JCMelendezT/IAoT/detector/resultados/deteccion_distancia_dron.xlsx

Detector de drones — detección contra distancia
Firmware nodo_detector en el ESP32-S3 · DJI Neo 2 con su control en 2,4 GHz · alerta = 2 ventanas seguidas de «dron»
Distancia (m) | En tierra | En vuelo | Tiempo hasta la alerta (s) | Notas
1 | sí | sí |  | Probado el 10-nov en el estudio
5 | sí |  |  | Dentro de casa, dron con motores apagados
8 |  | sí |  | Dentro de casa, dron volando
Resumen
Distancias probadas | 3
Detectado en tierra | 100%
Detectado en vuelo | 100%
Mayor distancia con alerta en tierra (m) | 5.0
Mayor distancia con alerta en vuelo (m) | 8.0
Tiempo promedio hasta la alerta (s)
Cómo llenarla
• Celdas amarillas: las llenas tú. «En tierra» y «En vuelo» tienen lista desplegable sí / no.
• Texto azul: datos escritos a mano, según lo que reportaste el 10-nov.
• El resumen se calcula solo con fórmulas; las celdas vacías no cuentan.
• «Tiempo hasta la alerta»: segundos desde que enciendes el control hasta que sale >>> ALERTA (lo esperado es unos 4 s).
