JCMelendezT/IAoT/detector/resultados/matriz_confusion.png

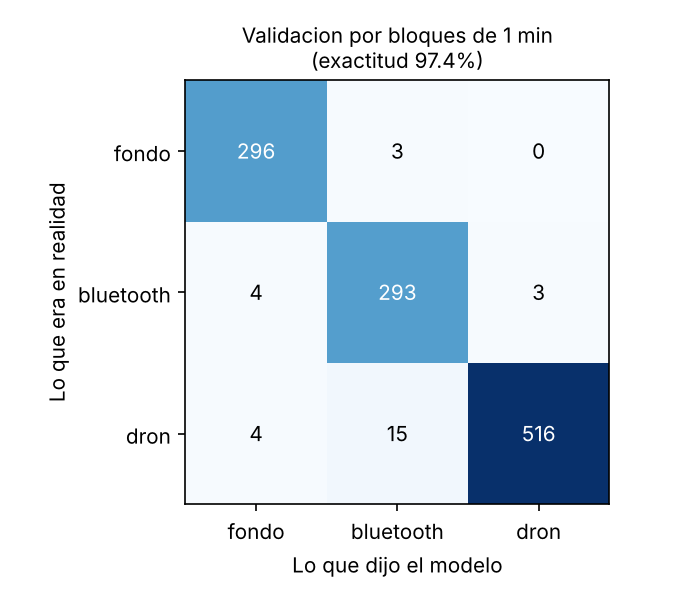
detector/resultados/matriz_confusion.png
