JCMelendezT/IAoT/firmware/devkit_centinela/app_web.h

// App del celular comprimida con gzip. Generado por app/empaquetar.py.
// No editar a mano: cambia index.html o entrenamiento.js y vuelve a correr el script.
#pragma once
#include <pgmspace.h>

const size_t APP_HTML_GZ_LEN = 14802;
const uint8_t APP_HTML_GZ[] PROGMEM = {
  0x1f, 0x8b, 0x08, 0x00, 0x00, 0x00, 0x00, 0x00, 0x02, 0xff, 0xbd, 0x7d, 0x4b, 0x93, 0x1b, 0xb9, 0xb5, 0xe6, 0x5e, 0xbf,
  0x22, 0x3b, 0xdd, 0x8f, 0x64, 0x8b, 0xcc, 0x2a, 0xd6, 0xab, 0xd5, 0xf5, 0xd2, 0xe8, 0xd9, 0x2d, 0x5b, 0xaf, 0xab, 0x92,
  0xbb, 0x6d, 0x97, 0xeb, 0x2a, 0x92, 0x64, 0x92, 0x95, 0x12, 0xc9, 0x64, 0x67, 0x92, 0xac, 0x2a, 0xc9, 0x8a, 0xf0, 0x6a,
  0x7e, 0xc0, 0xcc, 0xac, 0x26, 0x66, 0x16, 0xde, 0x4c, 0xc4, 0xc4, 0x44, 0x2f, 0x6e, 0xdc, 0xc5, 0x44, 0x78, 0x16, 0x13,
  0x61, 0xfd, 0x13, 0xff, 0x92, 0xf9, 0xce, 0x39, 0x00, 0x12, 0x48, 0x66, 0x92, 0x2c, 0xb5, 0x7a, 0x7c, 0xaf, 0xad, 0x22,
  0x12, 0x38, 0x00, 0x0e, 0xce, 0x1b, 0x07, 0xc0, 0xe1, 0x67, 0xbd, 0xb4, 0x3b, 0xbd, 0x9a, 0xc4, 0xde, 0xf9, 0x74, 0x34,
  0x3c, 0xbe, 0x71, 0x48, 0xff, 0x78, 0xc3, 0x68, 0x3c, 0x38, 0xf2, 0xe3, 0xdc, 0xa7, 0x82, 0x38, 0xea, 0xe1, 0x9f, 0x51,
  0x3c, 0x8d, 0xbc, 0xee, 0x79, 0x94, 0xe5, 0xf1, 0xf4, 0xc8, 0x9f, 0x4d, 0xfb, 0xad, 0x5b, 0xbe, 0x2e, 0x1e, 0x47, 0xa3,
  0xf8, 0xc8, 0x9f, 0x27, 0xf1, 0xc5, 0x24, 0xcd, 0xa6, 0xbe, 0xd7, 0x4d, 0xc7, 0xd3, 0x78, 0x8c, 0x6a, 0x17, 0x49, 0x6f,
  0x7a, 0x7e, 0xd4, 0x8b, 0xe7, 0x49, 0x37, 0x6e, 0xf1, 0x8f, 0xa6, 0x97, 0x8c, 0x93, 0x69, 0x12, 0x0d, 0x5b, 0x79, 0x37,
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
  0xf7, 0xbd, 0xdd, 0x65, 0xf3, 0x32, 0x98, 0x21, 0xe8, 0x98, 0x0b, 0xfa, 0xc7, 0x0a, 0x26, 0x3d, 0x55, 0x8d, 0x49, 0xaf,
  0x21, 0xe8, 0x56, 0xff, 0x31, 0x93, 0x69, 0xd3, 0x60, 0x47, 0xd1, 0x65, 0xd0, 0xde, 0x9b, 0x5c, 0x36, 0x2b, 0x07, 0x3d,
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
};
