JCMelendezT/IAoT/(commit log)

2026-10-19 Estructura inicial del repositorio IAoT
    Agrega AGENTS.md para OpenCode, índice de estado, bitácora de decisiones,
    plan de la Práctica 1 orientada al detector de drones por radiofrecuencia
    y el esqueleto de carpetas para firmware, captura de datos y ML.
    Los PDFs de clase quedan fuera del control de versiones.
    [sesiones.csv]
2026-10-19 Orientar la Práctica 1 al nodo detector, sin DHT
    El profesor autorizó cambiar el caso de uso. Los datos del servidor pasan a
    ser ventanas de rasgos WiFi, resumen del espectro nRF24, eventos de detección
    y latidos. Se renombra esp32-dht a esp32-cliente y se actualizan AGENTS.md,
    el índice y la bitácora de decisiones.
2026-10-19 Agregar plan completo por fases en lenguaje sencillo
    PLAN.md describe las fases 0 a 8 con qué hace cada quien y cómo saber que
    terminó, más riesgos, pendientes y glosario. Se registran como propuestas
    la arquitectura nodo sensor + pasarela, WSL2 en modo mirrored y RDS.
2026-10-19 Cambiar la nube de la Práctica 1 de AWS a Azure
    El profesor autorizó cualquier proveedor y hay crédito de Azure for Students.
    La Fase 3 del plan pasa a VM Ubuntu B1s con IP pública estática, PostgreSQL
    Flexible Server B1MS con acceso privado y NSG, con los cuidados de costo.
2026-10-20 Proponer pines del nRF24 en el ESP32-S3 e ignorar caché de OpenCode
2026-10-20 Confirmar placa ESP32-S3 y módulo nRF24 PA+LNA en PINOUT
2026-10-20 Confirmar conexión del nRF24: prueba de vida superada
    Agrega los sketches de Arduino de prueba de vida y diagnóstico del nRF24
    y marca los pines como confirmados en PINOUT.md.
2026-10-20 Agregar sketch Arduino de la cascada del espectro con nRF24
    Barre los 126 canales en modo solo receptor, cuenta las detecciones RPD
    en 8 barridos por fila e imprime una cascada en texto por el puerto serie.
2026-10-20 Registrar primeras capturas y detección del Neo 2 en 2,4 GHz
    Tres sesiones exploratorias en sesiones.csv (los archivos crudos quedan solo
    en local), decisión de capturar con el dron fijado en 2,4 GHz y avance de
    la Fase 1a en el índice.
    [sesiones.csv]
2026-10-20 Agregar sketch Arduino del sniffer WiFi en modo promiscuo
    Resume cada 2 s los emisores WiFi (MAC, fabricante, canal, tramas, tamaño,
    RSSI, tiempo entre tramas y SSID), marca los OUI registrados por DJI y
    permite saltar de canal o fijar uno desde el Monitor Serie.
2026-10-20 Registrar prueba del sniffer WiFi con el dron y su hallazgo
    [sesiones.csv]
2026-10-20 Registrar prueba del dron solo con celular (no visible en 2,4 GHz)
    [sesiones.csv]
2026-10-20 Agregar firmware nodo_captura y capturador con ventana para el PC
    nodo_captura corre el nRF24 y el sniffer WiFi a la vez. capturador.py
    (abrir con Capturar.bat) muestra la cascada en vivo y guarda cada sesión
    etiquetada en raw/ y en sesiones.csv. Se confirman las clases de entrenamiento.
2026-10-22 Agregar prueba de conexión WiFi del devkit y decisión de dos placas
2026-10-22 Prueba de red: servidor sin dependencias y latido del devkit
2026-10-22 Practica 1: nodo S3 por cable (UART) y pasarela devkit; latido sin WiFi propio
2026-10-22 Bitacora: Practica 1 parte 1 de punta a punta y pendientes para manana
    [sesiones.csv]
2026-10-22 Listo para compartir: IP del PC en cualquier red, grabacion de ejemplo para el simulador, guia en el README
2026-10-24 Diagramas de arquitectura (local, Azure, base de datos) y scripts de la parte 2 en Azure
2026-10-24 Diagramas: versiones Archify de las tres vistas de arquitectura
2026-10-24 Diagramas: saco el recibo de entrega de la carpeta publicada
2026-10-31 Nube: script para agregar mi IP al SSH sin borrar las anteriores
2026-10-31 Practica 2: broker MQTT, puente a InfluxDB y CSV, Grafana con alertas, InfluxDB en subred privada
    [devkit_mqtt.ino]
2026-10-31 Pausar P2 sin depender de PostgreSQL
2026-10-31 Practica 2: diagrama Archify de la arquitectura
2026-11-05 Practica 3 (AWS serverless), Terraform para Azure y AWS, firmware nRF24 y docs al dia
2026-11-10 Primer modelo del detector: regresion logistica con 3 clases (99,2 %)
    Capturas del 10-nov en el estudio a 1 m (fondo, bluetooth, dron con control en tierra y en vuelo).
    ml/rasgos.py arma ventanas de 2 s y ml/entrenar.py entrena, evalua por bloques de 1 minuto
    y exporta modelos/modelo_detector.h para el ESP32-S3.
    [prueba_prob.csv, prueba_rasgos.csv, sesiones.csv, ventanas.csv]
2026-11-10 Ventanas con el reloj del ESP32 y modelo reentrenado (99,3 %)
    rasgos.py toma las filas del nRF24 por el ms del ESP32 en los 2 s antes de cada linea W,
    igual que el firmware; antes a veces entraba una fila llegada despues (~6 % de ventanas).
    entrenar.py copia modelo_detector.h al sketch nodo_detector.
    [prueba_prob.csv, prueba_rasgos.csv, ventanas.csv]
2026-11-10 Firmware nodo_detector: el modelo corre en el ESP32-S3
    Calcula los 28 rasgos en C++ (rasgos_detector.h), clasifica fondo/bluetooth/dron cada 2 s,
    alerta con 2 ventanas seguidas de dron y LED RGB de la placa. prueba_pc/ compara el calculo
    con Python: 1134 de 1134 ventanas con la misma clase. Compila con el core ESP32 3.1.1.
2026-11-10 Pantalla tactica TFT y voz de alerta ISD1820 en nodo_detector; resultados de distancia
    Pantalla ST7735 en bus SPI propio: chequeo de arranque, cascada en vivo, probabilidad de dron
    y alerta parpadeante. ISD1820 en GPIO 16 repite el aviso cada 12 s. Se activa con
    USAR_PANTALLA_Y_VOZ. Primera prueba en la placa: alerta a 5 m (tierra) y 8 m (vuelo) en casa.
    [deteccion_distancia_dron.xlsx]
2026-11-10 Pines de la pantalla y del ISD1820 con las etiquetas reales de los modulos
2026-11-11 Pantalla a 10 MHz para cables de protoboard y sketch prueba_pantalla
    La libreria arranca el ST7735 a 32 MHz y con cables largos la pantalla queda en blanco:
    se repite la secuencia de arranque a 10 MHz. prueba_pantalla usa SPI por software para
    revisar cables y alimentacion sin depender del detector.
2026-11-11 prueba_pantalla recorre sola las 4 formas de arrancar el ST7735
2026-11-11 Pantalla: VCC a 5V (el modulo trae regulador y con 3V3 queda en blanco)
2026-11-11 prueba_pantalla: opcion para probar la pantalla en los pines del nRF24
2026-11-11 Sistema completo sin pantalla: sonido ISD1820 y alerta del modelo hasta AWS
    nodo_detector: USAR_VOZ (voz_alerta.h, suena al arrancar y en la alerta), USAR_PANTALLA en 0
    y USAR_PASARELA: manda V, D (decision del modelo) y E por el GPIO 17 al devkit.
    devkit_aws publica clase y prob_dron y usa la alerta del modelo. Dashboard y CSV de la
    Practica 3 muestran la clasificacion de la IA.
2026-11-12 Modelo solo con el espectro: sin falsas alarmas de noche
    Con los rasgos del trafico WiFi el modelo aprendio 'poco trafico = dron' y de noche alertaba.
    Sin ellos: 97,4 % por bloques de 1 min, 0 falsas alarmas con la regla de 2 ventanas y 0 % con
    trafico de noche simulado. El firmware no cambia: elige los rasgos por nombre.
    [prueba_prob.csv, prueba_rasgos.csv]
2026-11-12 S3: modelo cambiable desde la app, ajustes guardados y rasgos por ventana
    modelo_activo.h: el S3 recibe por el GPIO 18 un modelo nuevo (linea M con hash), lo guarda en
    NVS y lo usa sin reflashear; X vuelve al de fabrica; C cambia ventanas de alerta y sonido.
    Manda por cada ventana una linea R con los 35 rasgos para la caja negra del devkit.
2026-11-12 devkit_centinela y app del iPhone: caja negra, etiquetar y reentrenar en el celular
    El devkit guarda cada ventana en LittleFS y sirve la app en http://detector.local (o su red
    CENTINELA-RF): en vivo, grabar sesiones etiquetadas, etiquetar rangos, reentrenar en el
    navegador (igual a entrenar.py) y mandar el modelo al S3. AWS sigue opcional. Terraform
    escribe certs.h tambien para devkit_centinela.
2026-11-13 Práctica 2: quita la IP pública de la VM de scripts y ejemplos
    El simulador ahora pide --host y los scripts leen la IP de infra.env.
2026-11-13 Diagramas del sistema, la decisión del modelo y el reentrenamiento
    Hechos con Archify; el .json de cada uno es la fuente.
2026-11-13 Reorganiza el repositorio y reescribe la documentación
    - firmware/: nodo_detector, devkit_centinela, nodo_captura y las pruebas
    - app/: la app del celular (antes Lab_ESP32/app_centinela)
    - detector/: captura, entrenamiento, modelo y resultados
    - docs/: hardware, decisiones y material del curso
    - Rutas actualizadas en entrenar.py, comparar.py, main.tf y la app
    - Notas de trabajo fuera del repo
    [deteccion_distancia_dron.xlsx, prueba_prob.csv, prueba_rasgos.csv, sesiones.csv, ventanas.csv]
2026-11-14 devkit_centinela: varias redes WiFi, incluido el internet compartido del celular
    Se une a la red conocida con más señal y, si no hay ninguna, crea CENTINELA-RF
    y vuelve a buscar cada minuto. La app muestra la red y la IP.
2026-11-14 devkit_centinela: agregar, probar y quitar redes WiFi desde la app
    Hasta 5 redes guardadas en la memoria del devkit, búsqueda de redes cercanas,
    prueba de conexión y red propia CENTINELA-RF solo mientras no hay WiFi.
2026-11-14 Servidor MCP de solo lectura: eventos recientes y episodios de alerta
    Lee la API del devkit_centinela. Incluye un devkit falso para probarlo sin la placa.
2026-11-14 MCP: la dirección del devkit se pasa como argumento
    --env de claude mcp add se traga el nombre del servidor; con un argumento final el comando no falla.
